TunerTools/TTuaefi/gerber/alphax_4ch.csv

Comment | Designator | Footprint | LCSC Part #
10n | C1 | hellen-one-common:C0603 | C57112
100n | C2 | hellen-one-common:C0603 | C14663
10n | C3 | hellen-one-common:C0603 | C57112
1n | C4 | hellen-one-common:C0603 | C1588
100n | C5 | hellen-one-common:C0603 | C14663
100n | C6 | hellen-one-common:C0603 | C14663
22u | C7 | hellen-one-common:C0603 | C59461
1n 250V | C8 | hellen-one-common:C0603 | C277510
1n 250V | C9 | hellen-one-common:C0603 | C277510
1n 250V | C17 | hellen-one-common:C0603 | C277510
100n | C18 | hellen-one-common:C0603 | C14663
100n | C19 | hellen-one-common:C0603 | C14663
1n 250V | C20 | hellen-one-common:C0603 | C277510
1n 250V | C21 | hellen-one-common:C0603 | C277510
470uF | C22 | Capacitor_SMD:CP_Elec_10x10.5
10u | C45 | hellen-one-common:C0805 | C15850
10u | C46 | hellen-one-common:C0805 | C15850
10u | C47 | hellen-one-common:C0805 | C15850
10u | C48 | hellen-one-common:C0805 | C15850
10u | C49 | hellen-one-common:C0805 | C15850
10u | C50 | hellen-one-common:C0805 | C15850
10u | C51 | hellen-one-common:C0805 | C15850
10u | C52 | hellen-one-common:C0805 | C15850
10u | C53 | hellen-one-common:C0805 | C15850
10u | C54 | hellen-one-common:C0805 | C15850
100n | C55 | hellen-one-common:C0603 | C14663
1N4148WS | D1 | hellen-one-common:SOD-323 | C2128
1N4148WS | D2 | hellen-one-common:SOD-323 | C2128
1N4148WS | D3 | hellen-one-common:SOD-323 | C2128
LED-WHITE-0603 | D4 | hellen-one-common:LED-0603 | C2290
1N4148WS | D5 | hellen-one-common:SOD-323 | C2128
1N4148WS | D6 | hellen-one-common:SOD-323 | C2128
1N4148WS | D7 | hellen-one-common:SOD-323 | C2128
1N4148WS | D8 | hellen-one-common:SOD-323 | C2128
LED-RED-0603 | D9 | hellen-one-common:LED-0603 | C2286
LED-WHITE-0603 | D10 | hellen-one-common:LED-0603 | C2290
LED-RED-0603 | D13 | hellen-one-common:LED-0603 | C2286
LED-RED-0603 | D14 | hellen-one-common:LED-0603 | C2286
LED-RED-0603 | D15 | hellen-one-common:LED-0603 | C2286
LED-RED-0603 | D16 | hellen-one-common:LED-0603 | C2286
LED-RED-0603 | D17 | hellen-one-common:LED-0603 | C2286
BAT54S | D18 | Package_TO_SOT_SMD:SOT-23 | C47546
BAT54S | D19 | Package_TO_SOT_SMD:SOT-23 | C47546
LED-GREEN-0603 | D20 | hellen-one-common:LED-0603 | C72043
1N4148WS | D21 | hellen-one-common:SOD-323 | C2128
1N4148WS | D22 | hellen-one-common:SOD-323 | C2128
BAT54S | D23 | Package_TO_SOT_SMD:SOT-23 | C47546
1N4148WS | D24 | hellen-one-common:SOD-323 | C2128
PSM712-LF | D25 | hellen-one-common:SOT-23 | C32677
B5819W | D26 | hellen-one-common:SOD-123 | C8598
B5819W | D27 | hellen-one-common:SOD-123 | C8598
PSM712-LF | D28 | hellen-one-common:SOT-23 | C32677
PSM712-LF | D29 | hellen-one-common:SOT-23 | C32677
LED-RED-0603 | D31 | hellen-one-common:LED-0603 | C2286
LED-RED-0603 | D32 | hellen-one-common:LED-0603 | C2286
LED-WHITE-0603 | D33 | hellen-one-common:LED-0603 | C2290
LED-WHITE-0603 | D34 | hellen-one-common:LED-0603 | C2290
LED-WHITE-0603 | D35 | hellen-one-common:LED-0603 | C2290
LED-WHITE-0603 | D36 | hellen-one-common:LED-0603 | C2290
1N4148WS | D37 | hellen-one-common:SOD-323 | C2128
1N4148WS | D38 | hellen-one-common:SOD-323 | C2128
LED-RED-0603 | D39 | hellen-one-common:LED-0603 | C2286
LED-RED-0603 | D40 | hellen-one-common:LED-0603 | C2286
1N4148WS | D41 | hellen-one-common:SOD-323 | C2128
1N4148WS | D42 | hellen-one-common:SOD-323 | C2128
LED-RED-0603 | D43 | hellen-one-common:LED-0603 | C2286
LED-RED-0603 | D44 | hellen-one-common:LED-0603 | C2286
1N4148WS | D45 | hellen-one-common:SOD-323 | C2128
1N4148WS | D46 | hellen-one-common:SOD-323 | C2128
LED-RED-0603 | D47 | hellen-one-common:LED-0603 | C2286
LED-RED-0603 | D48 | hellen-one-common:LED-0603 | C2286
B5819W | D49 | hellen-one-common:SOD-123 | C8598
B5819W | D50 | hellen-one-common:SOD-123 | C8598
B5819W | D51 | hellen-one-common:SOD-123 | C8598
B5819W | D52 | hellen-one-common:SOD-123 | C8598
1N4148WS | D53 | hellen-one-common:SOD-323 | C2128
BAT54S | D55 | Package_TO_SOT_SMD:SOT-23 | C47546
LED-RED-0603 | D56 | hellen-one-common:LED-0603 | C2286
LED-RED-0603 | D57 | hellen-one-common:LED-0603 | C2286
BAT54S | D58 | Package_TO_SOT_SMD:SOT-23 | C47546
B5819W | D64 | hellen-one-common:SOD-123 | C8598
B5819W | D65 | hellen-one-common:SOD-123 | C8598
B5819W | D66 | hellen-one-common:SOD-123 | C8598
B5819W | D67 | hellen-one-common:SOD-123 | C8598
B5819W | D68 | hellen-one-common:SOD-123 | C8598
B5819W | D69 | hellen-one-common:SOD-123 | C8598
B5819W | D70 | hellen-one-common:SOD-123 | C8598
B5819W | D71 | hellen-one-common:SOD-123 | C8598
B5819W | D72 | hellen-one-common:SOD-123 | C8598
nSMD005 | F1 | hellen-one-common:PAD-1206-PAD | C369153
nSMD005 | F2 | hellen-one-common:PAD-1206-PAD | C369153
nSMD050 | F3 | hellen-one-common:PAD-1206-PAD | C720075
nSMD050 | F4 | hellen-one-common:PAD-1206-PAD | C720075
12H1500D | F5 | hellen-one-common:PAD-1206-PAD | C182446
12H1500D | F6 | hellen-one-common:PAD-1206-PAD | C182446
nSMD050 | F7 | hellen-one-common:PAD-1206-PAD | C720075
nSMD005 | F8 | hellen-one-common:PAD-1206-PAD | C369153
nSMD005 | F9 | hellen-one-common:PAD-1206-PAD | C369153
nSMD005 | F10 | hellen-one-common:PAD-1206-PAD | C369153
nSMD005 | F11 | hellen-one-common:PAD-1206-PAD | C369153
RUSEFI_LOGO | G1 | kicad6-libraries:rusefi_logo
LOGO | G3 | hellen-one-common:LOGO
LOGO_AlphaECU | G4 | kicad6-libraries:alphax_logo_AlphaECU
LOGO_AlphaX | G5 | kicad6-libraries:alphax_logo_AlphaX
ALPHAX_QR_CODE | G6 | kicad6-libraries:alphax_qr_code
Disclaimer | G7 | kicad6-libraries:Off_Road_Disclaimer
USB_C_Receptacle_USB2.0 | J1 | Connector_USB:USB_C_Receptacle_XKB_U262-16XN-4BVC11 | C2927038
Cortex_Debug | J2 | hellen-one-common:PinHeader_2x05_P1.27mm_Vertical_SMD | C448647
Conn_01x01 | J3 | TestPoint:TestPoint_Pad_D2.0mm
Conn_01x01 | J4 | TestPoint:TestPoint_Pad_D2.0mm
Conn_01x05_Male | J5 | Connector_Molex:Molex_SPOX_5267-05A_1x05_P2.50mm_Vertical
430451012 | J6 | Connector_Molex:Molex_Micro-Fit_3.0_43045-1012_2x05_P3.00mm_Vertical | C239457
Conn_01x01 | J7 | MountingHole:MountingHole_4.5mm_Pad
Conn_01x01 | J8 | MountingHole:MountingHole_4.5mm_Pad
Module-power_12and5V-0.2 | M1 | hellen-one-power_12and5V-0.2:power_12and5V
Module-ign8-0.2 | M2 | hellen-one-ign8-0.2:ign8
Module-vr-discrete-0.4 | M3 | hellen-one-vr-discrete-0.4:vr-discrete
Module-mega-mcu144-0.5 | M4 | hellen-one-mega-mcu144-0.5:mega-mcu144
Module-ign8-0.2 | M6 | hellen-one-ign8-0.2:ign8
Module-vr-discrete-0.4 | M8 | hellen-one-vr-discrete-0.4:vr-discrete
Module-knock-0.2 | M9 | hellen-one-knock-0.2:knock
HCCPHPE24BKA90F | P1 | kicad6-libraries:33311-24AW-2
HCCPHPE24BGYB90F | P2 | kicad6-libraries:33311-24AW-2
Pad | P4 | hellen-one-common:PAD-TH
Pad | P16 | hellen-one-common:PAD-TH
Pad | P17 | hellen-one-common:PAD-TH
Pad | P18 | hellen-one-common:PAD-TH
Pad | P19 | hellen-one-common:PAD-TH
Pad | P21 | hellen-one-common:PAD-TH
Pad | P22 | hellen-one-common:PAD-TH
Pad | P23 | hellen-one-common:PAD-TH
Pad | P24 | hellen-one-common:PAD-TH
Pad | P25 | hellen-one-common:PAD-TH
Pad | P26 | hellen-one-common:PAD-TH
Pad | P27 | hellen-one-common:PAD-TH
Pad | P28 | hellen-one-common:PAD-TH
AO3400A | Q1 | hellen-one-common:SOT-23 | C20917
PJM2319PSA | Q2 | Package_TO_SOT_SMD:SOT-23 | C411720
AO3400A | Q3 | hellen-one-common:SOT-23 | C20917
AO3400A | Q4 | hellen-one-common:SOT-23 | C20917
VND14NV04-E | Q6 | hellen-one-common:DPAK | C155647
VND14NV04-E | Q7 | hellen-one-common:DPAK | C155647
AO3400A | Q8 | hellen-one-common:SOT-23 | C20917
AO3400A | Q9 | hellen-one-common:SOT-23 | C20917
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
2k | R1141 | Resistor_SMD:R_1206_3216Metric | C17944
MAX9924UAUB+ | U1 | Package_SO:MSOP-10_3x3mm_P0.5mm | C143633
MPXH6400A | U3 | hellen-one-common:MPXH6400A-SSOP8 | C511770
JDY-33 | U4 | kicad6-libraries:JDY-33
TLE9201SG | U7 | Package_SO:Infineon_PG-DSO-12-11 | C112633
