TunerTools/TTuaefi/bom_pullups_alphax_4ch-g.csv

#CRANK 680k UP
R220 | 680k | R0402 | C163456
R226
#CAM EXT
R220
R224
#VSS EXT
R219
R223
#TPS 680k DOWN
R204
R208 | 680k | R0402 | C163456
#TPS2 EXT
R202
R206
#PPS 680k DOWN
R203
R207 | 680k | R0402 | C163456
#PPS2 EXT
R201
R205
#IAT EXT
R213
R217
#AT1 4.7k UP
R212 | 4.7k | R0402 | C25900
R216
#CLT EXT
R211
R215
#AT2 4.7k UP
R210 | 4.7k | R0402 | C25900
R214
#O2S 680k DOWN
R238
R242 | 680k | R0402 | C163456
#O2S2 680k DOWN
R239
R243 | 680k | R0402 | C163456
#RES1 680k UP
R237 | 680k | R0402 | C163456
R241
C216 | 10n | C0603 | C15195
#RES2 EXT
R240
R244
C219
#RES3 EXT
R231
R235
C215
#MAP1 10k DOWN
R228
R232 | 10k | R0402 | C11616
#MAP2 10k DOWN
R229
R233 | 10k | R0402 | C11616
#MAP3 10k DOWN
R230
R234 | 10k | R0402 | C11616
#AUX1 680k DOWN
R246
R250 | 680k | R0402 | C163456
#AUX2 680k DOWN
R247
R251 | 680k | R0402 | C163456
#AUX3 EXT
R248
R252
#AUX4 EXT
R249
R253
C228
#SENS1 EXT
R259
R263
#SENS2 EXT
R260
R264
#SENS3 EXT
R261
R265
#SENS4 EXT
R262
R266
#KNOCK 680k DOWN
R221
R225 | 680k | R0402 | C163456
#D1-D4 0 series
R140 | 0 | R0603x4 | C1952
#D1 EXT
R124
R136
#D2 EXT
R126
R137
#D3 EXT
R132
R138
#D4 EXT
R135
R139
