TunerTools/TTuaefi/bom_pullups_alphax_4ch-h.csv

#CRANK CRANK VR: UP 680k 1n
R222,"680k","R0402","C163456"
R226,
C211,"1n","C0402","C1523"
#CAM CAM HALL: DOWN DNP 1n
R220,
R224,
C209,"1n","C0402","C1523"
#VSS 2STEP: DOWN DNP 1n
R219,
R223,
C208,"1n","C0402","C1523"
#TPS TPS1: DOWN 680k 100n
R204,
R208,"680k","R0402","C163456"
C203,"100n","C0402","C307331"
#TPS2 AIN1: DOWN DNP 1n
R202,
R206,
C201,"1n","C0402","C1523"
#PPS PPS1: DOWN 680k 100n
R203,
R207,"680k","R0402","C163456"
C202,"100n","C0402","C307331"
#PPS2 AIN2: DOWN DNP 1n
R201,
R205,
C200,"1n","C0402","C1523"
#IAT IAT: UP DNP 100n
R213,
R217,
C207,"100n","C0402","C307331"
#AT1 PAD: UP 4.7k 100n
R212,"4.7k","R0402","C25900"
R216,
C206,"100n","C0402","C307331"
#CLT CLT: UP DNP 100n
R211,
R215,
C205,"100n","C0402","C307331"
#AT2 PAD: UP 4.7k 100n
R210,"4.7k","R0402","C25900"
R214,
C204,"100n","C0402","C307331"
#O2S WakeUP: DOWN 680k 100n
R238,
R242,"680k","R0402","C163456"
C217,"100n","C0402","C307331"
#O2S2 AFR: DOWN 680k 100n
R239,
R243,"680k","R0402","C163456"
C218,"100n","C0402","C307331"
#RES1 CAM VR: UP 680k 1n
R237,"680k","R0402","C163456"
R241,
C216,"1n","C0402","C1523"
#RES2 CAM VR ANALOG: UP DNP 1n
R240,
R244,
C219,"1n","C0402","C1523"
#RES3 CRANK VR ANALOG: UP DNP 1n
R231,
R235,
C215,"1n","C0402","C1523"
#MAP1 AIN3: DOWN DNP 1n
R228,
R232,
C212,"1n","C0402","C1523"
#MAP2 MAP: DOWN 10k 10n
R229,
R233,"10k","R0402","C25744"
C213,"10n","C0402","C15195"
#MAP3 MAP2: DOWN 10k 10n
R230,
R234,"10k","R0402","C25744"
C214,"10n","C0402","C15195"
#AUX1 TPS2: DOWN 680k 100n
R246,
R250,"680k","R0402","C163456"
C225,"100n","C0402","C307331"
#AUX2 PPS2: DOWN 680k 100n
R247,
R251,"680k","R0402","C163456"
C226,"100n","C0402","C307331"
#AUX3 AIN4: DOWN DNP 1n
R248,
R252,
C227,"1n","C0402","C1523"
#AUX4 FLEX: UP DNP DNP
R249,
R253,
C228,
#SENS1 D2: UP DNP 1n
R259,
R263,
C230,"1n","C0402","C1523"
#SENS2 D3: UP DNP 1n
R260,
R264,
C231,"1n","C0402","C1523"
#SENS3 D4: UP DNP 1n
R261,
R265,
C232,"1n","C0402","C1523"
#SENS4 D5: UP DNP 1n
R262,
R266,
C233,"1n","C0402","C1523"
#KNOCK KNOCK: DOWN 680k 1n
R221,
R225,"680k","R0402","C163456"
C210,"1n","C0402","C1523"
#D1 HALL1: UP DNP 1n
R124,
R136,
C143,"1n","C0402","C1523"
#D2 TLS115_PG: UP DNP 1n
R126,
R137,
C144,"1n","C0402","C1523"
#D3 HALL2: UP DNP 1n
R132,
R138,
C145,"1n","C0402","C1523"
#D4 HALL3: UP DNP 1n
R135,
R139,
C146,"1n","C0402","C1523"
