TunerTools/TTuaefi/gerber/alphax_4ch.pdf

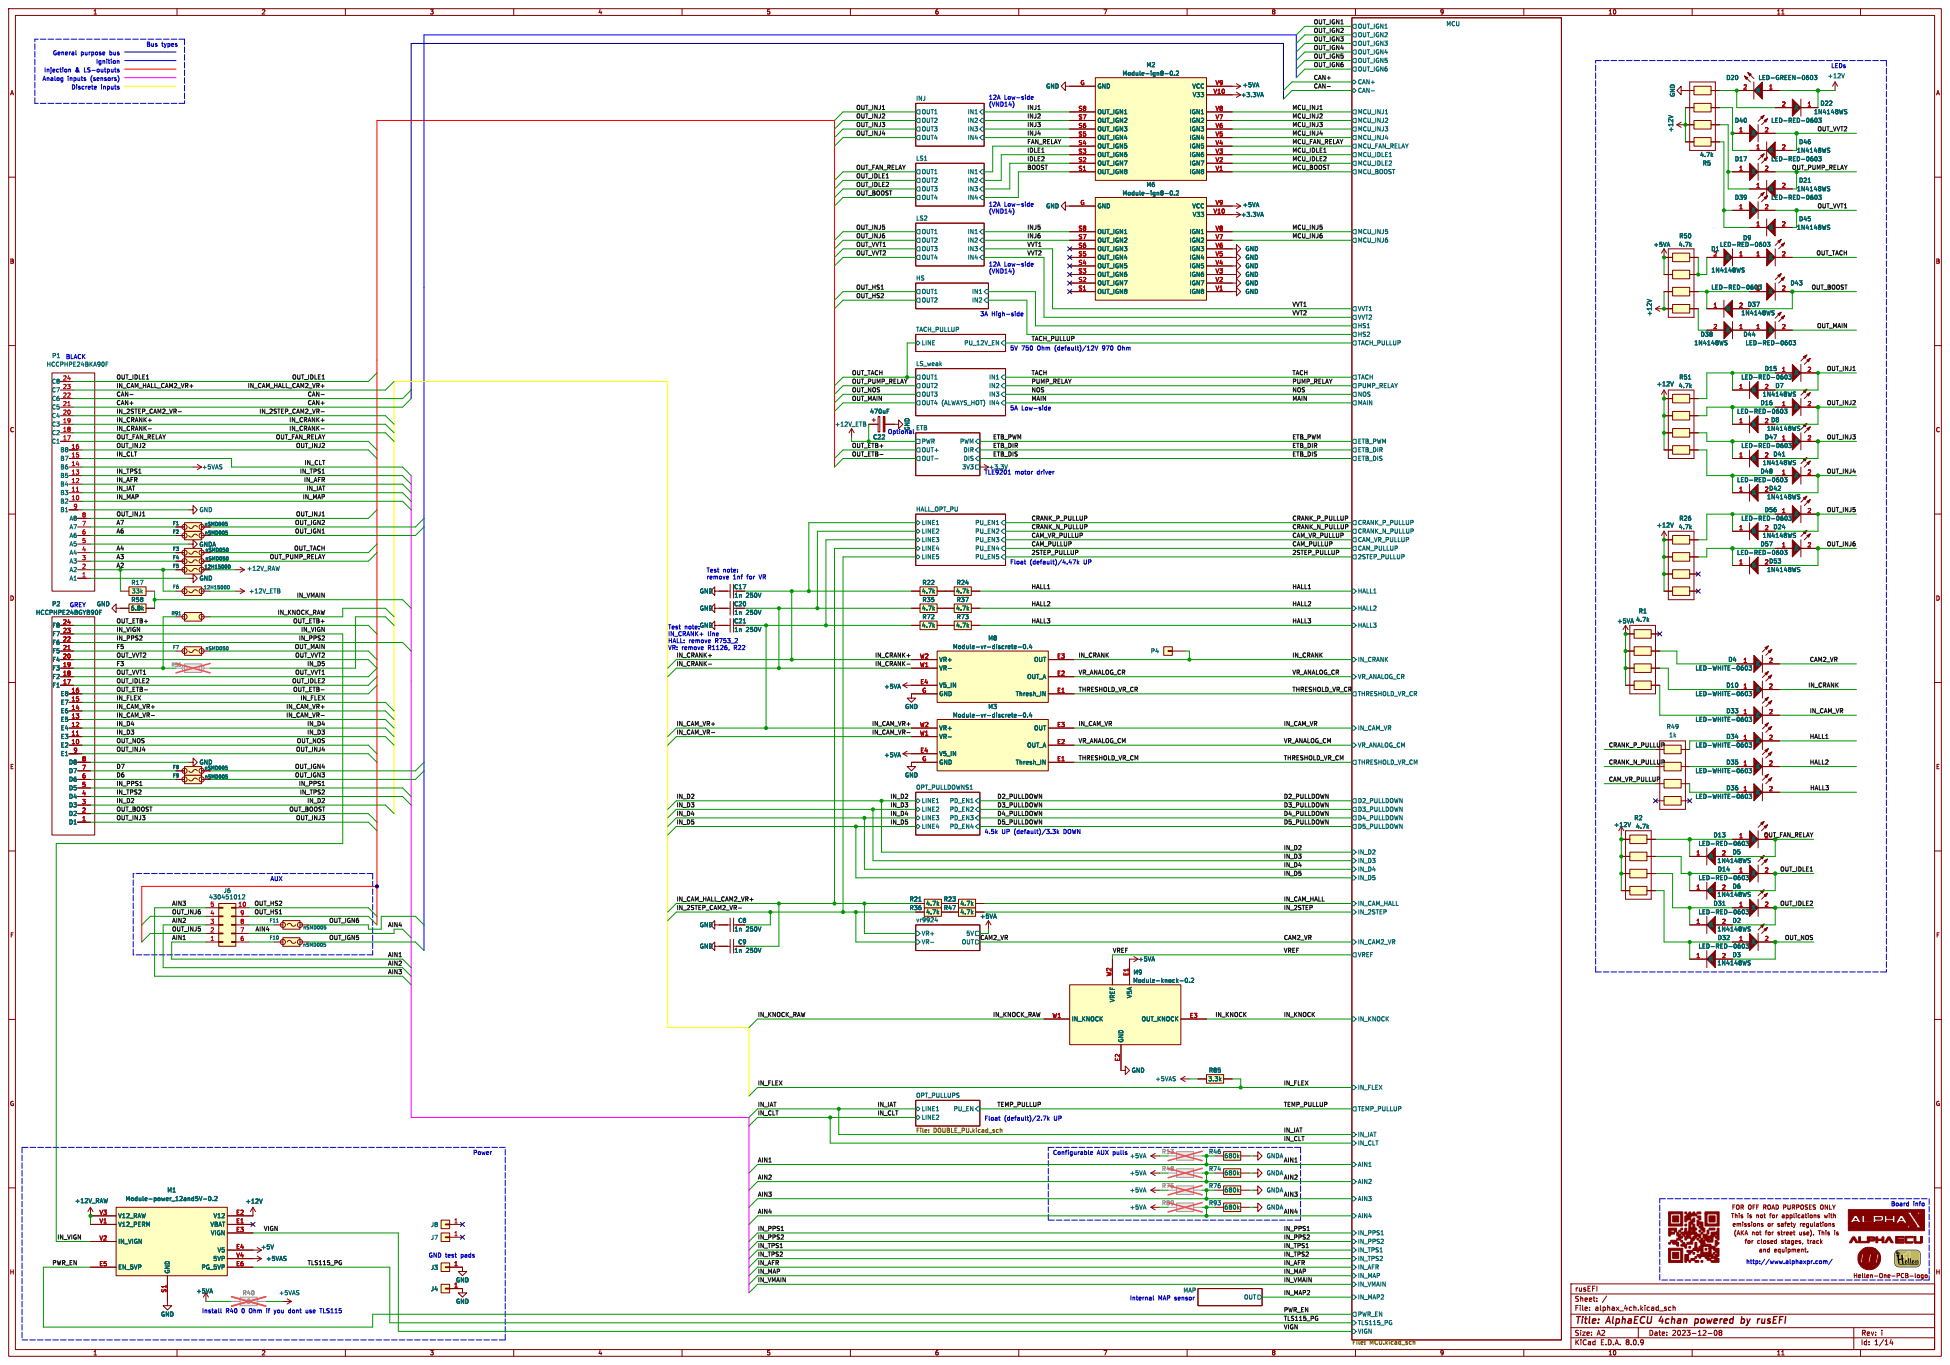
[picture p1: page 1]

+5VA GND GND GND GND GND GND

TLE9201 motor driver 5A Low-side

Test note: remove 1nf for VR

Test note:
IN_CRANK+ line HALL: remove R753_2 VR: remove R1126, R22

for closed stages, track FOR OFF ROAD PURPOSES ONLY

http://www.alphaxpr.com/

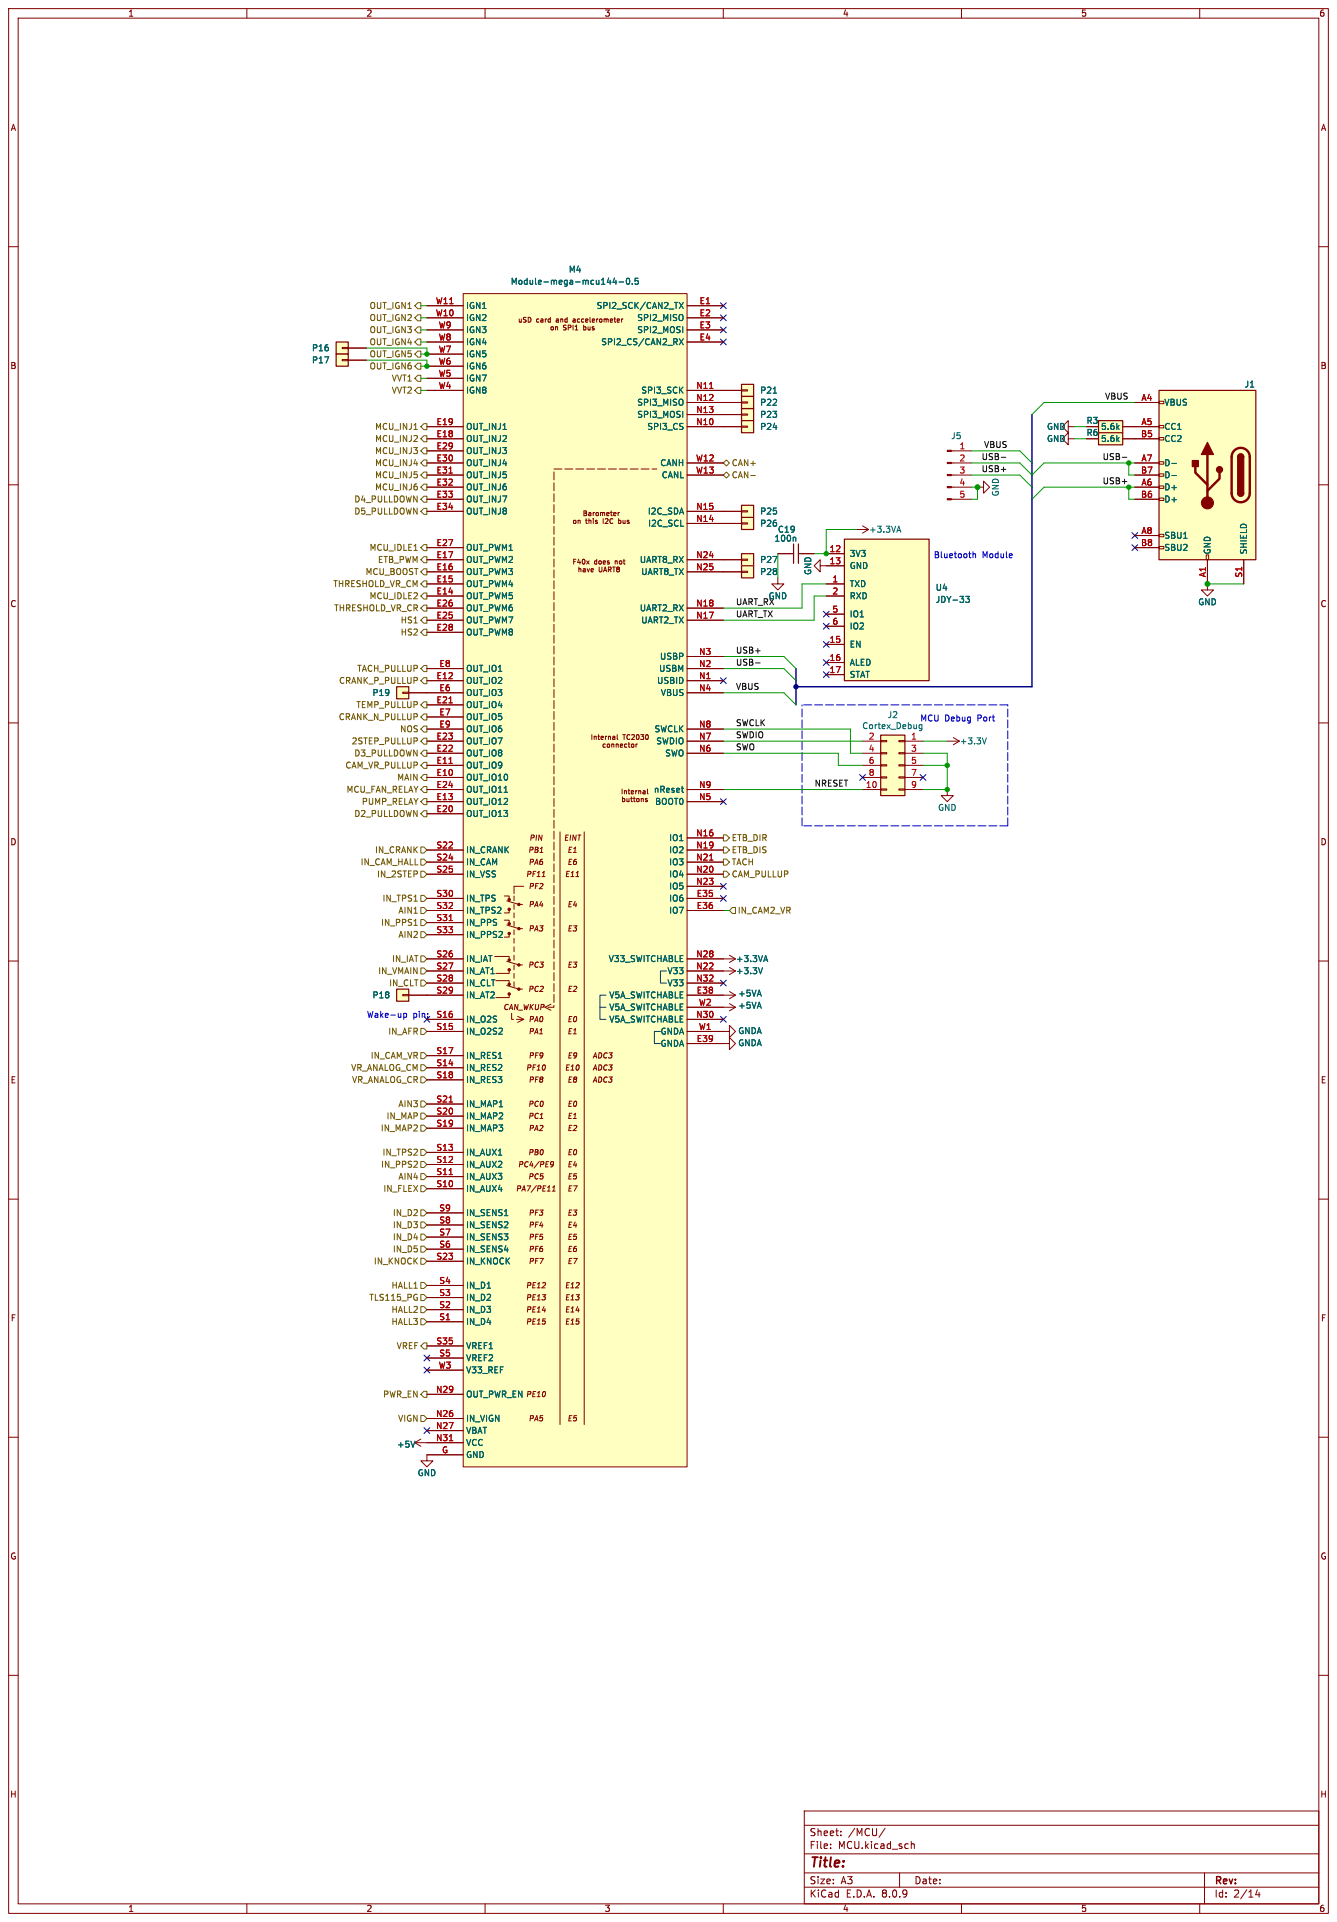
[picture p2: page 2]

100n P28GND
3V3 12 GND 13 EN 15 ALED 16 STAT 17 RXD 2
IO2 6 GND
JDY-33 TXD 1

Id: 2/14 Title: File: MCU.kicad_sch Sheet: /MCU/

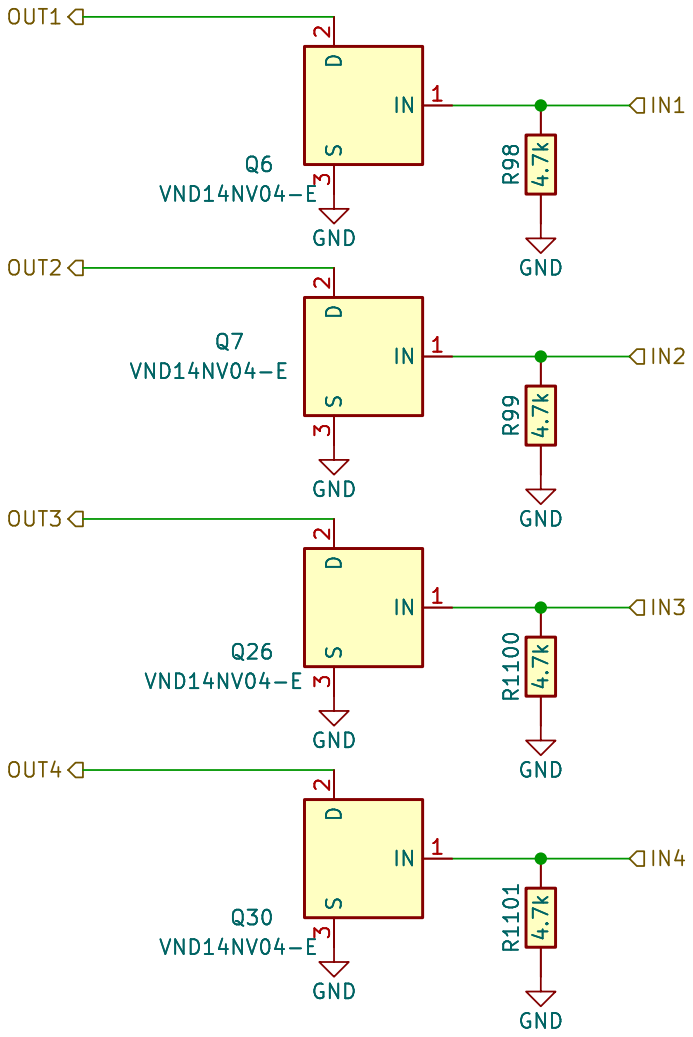
[picture p3: page 3]

Id: 3/14 Title: File: INJ4.kicad_sch Sheet: /INJ/

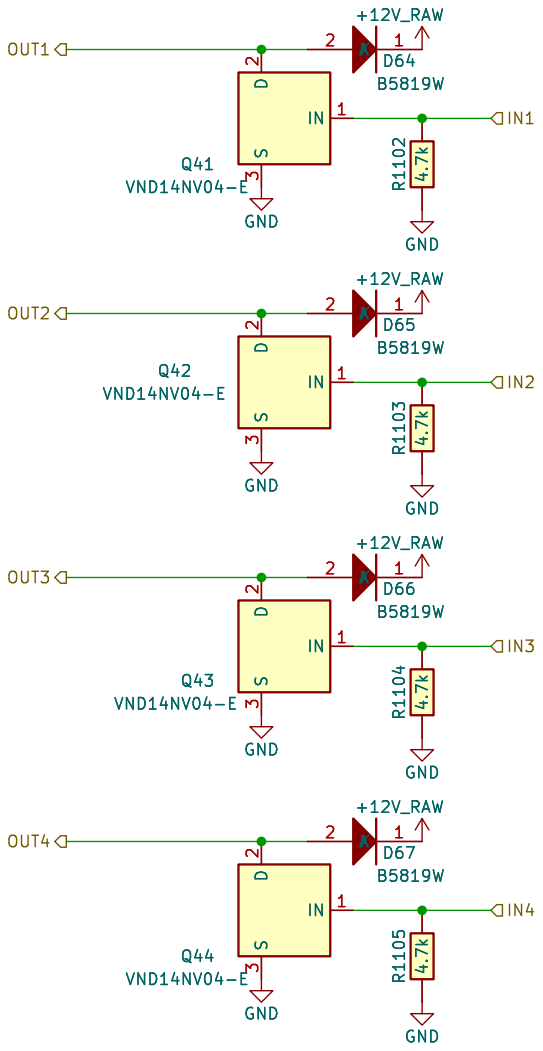
[picture p4: page 4]

Id: 4/14 Title: File: LS4.kicad_sch Sheet: /LS1/ GND

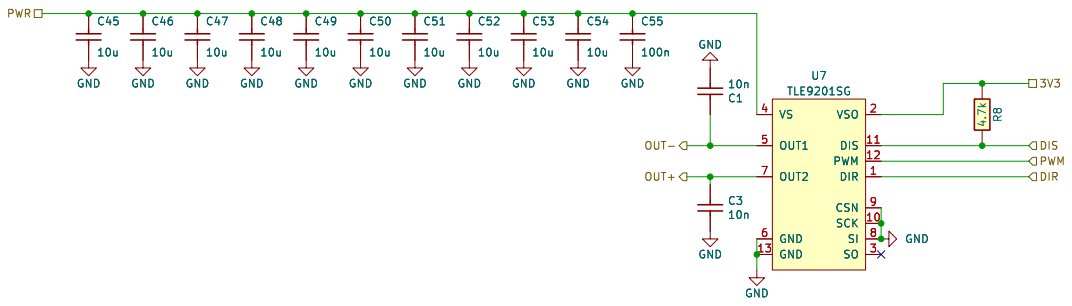
[picture p5: page 5]

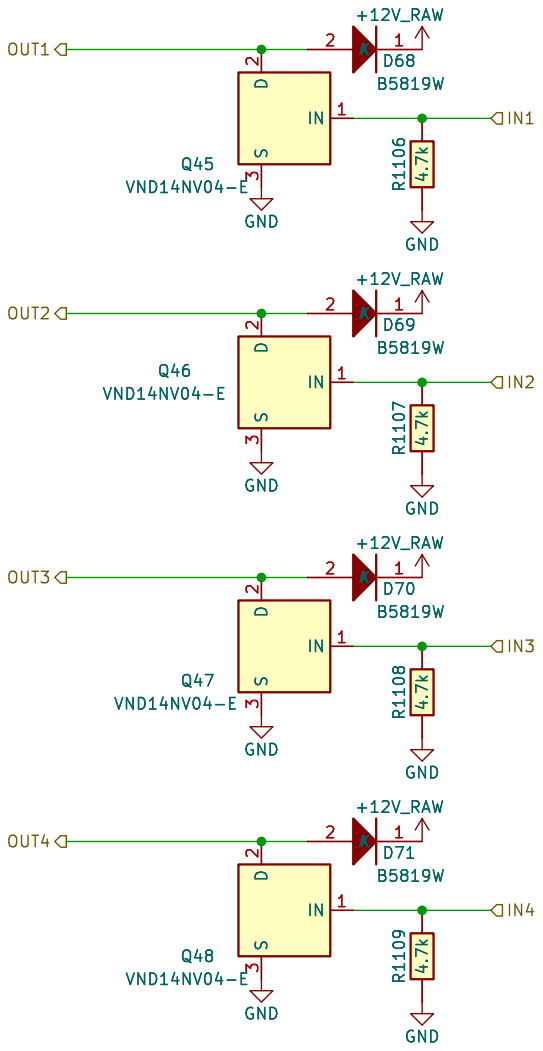
[picture p6: page 6]

Id: 6/14 Title: File: LS4.kicad_sch Sheet: /LS2/

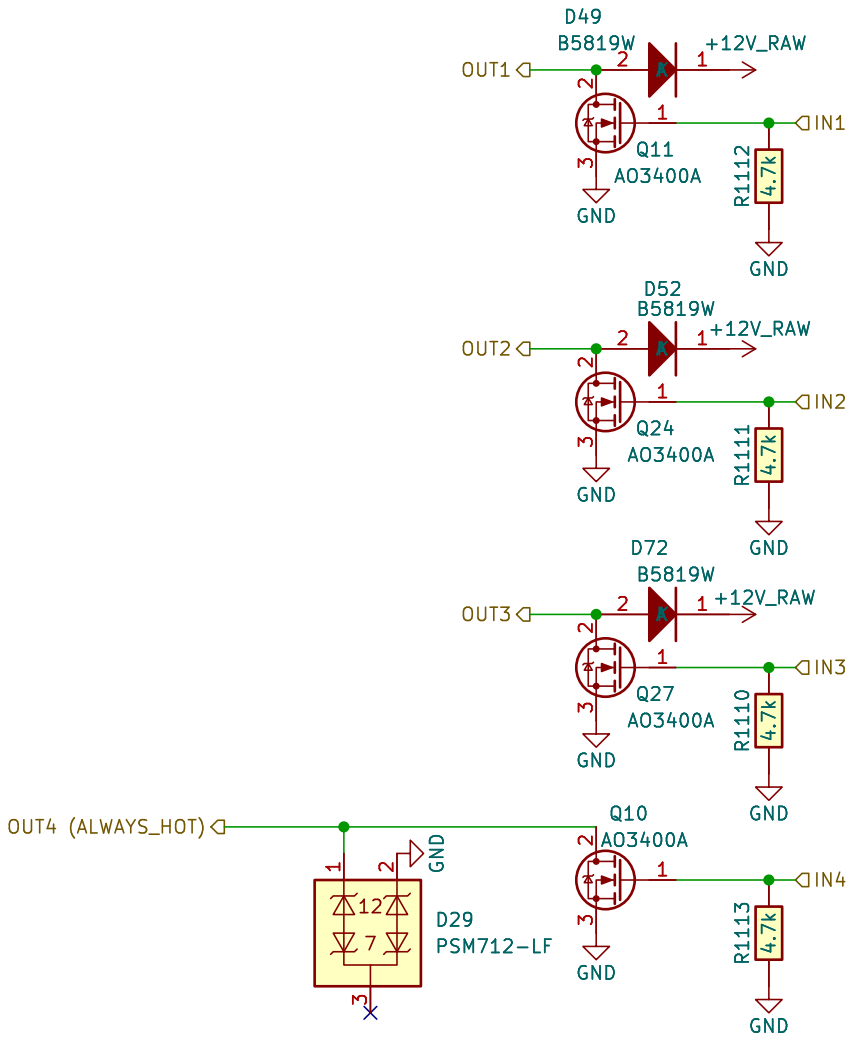
[picture p7: page 7]

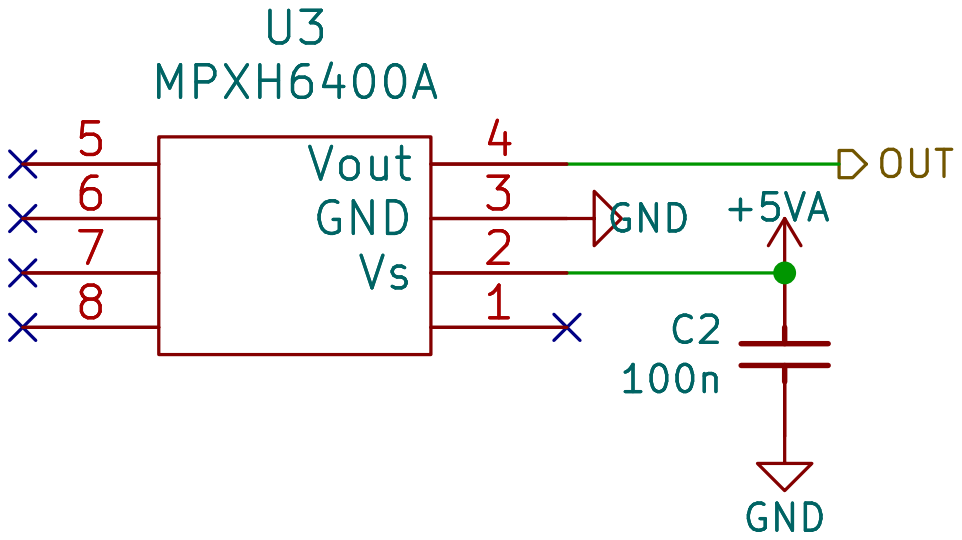
[picture p8: page 8]

Id: 8/14 Title: File: MAP.kicad_sch Sheet: /MAP/

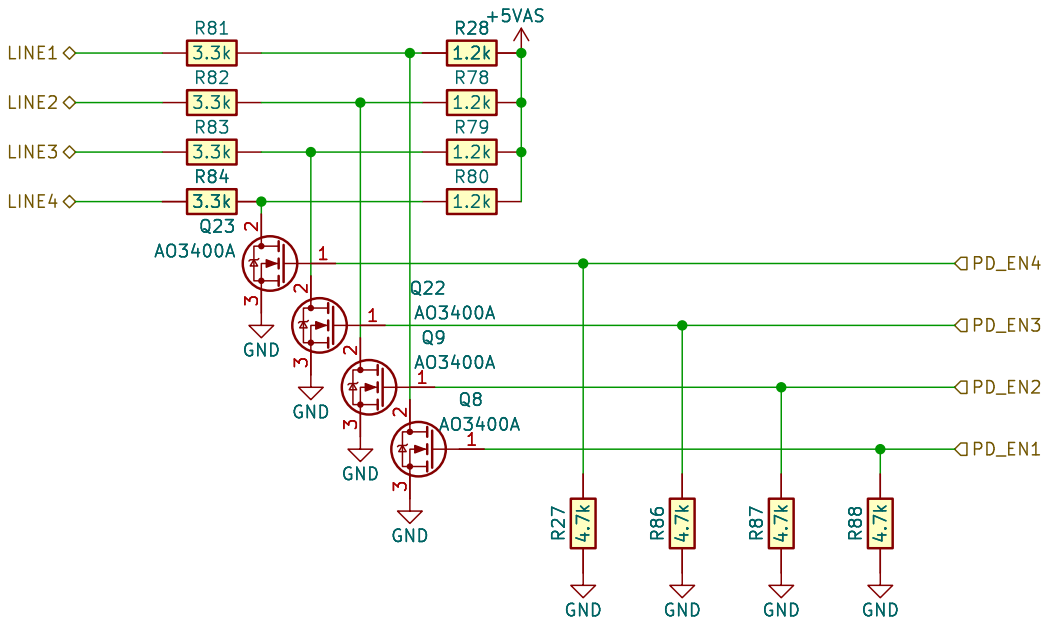
[picture p9: page 9]

2 3 GND GND R27 4.7k R86 4.7k GND GND GND R87 4.7k R88 4.7k R28

1.2k GND

Id: 9/14 Title: File: PD4.kicad_sch Sheet: /OPT_PULLDOWNS1/ GND

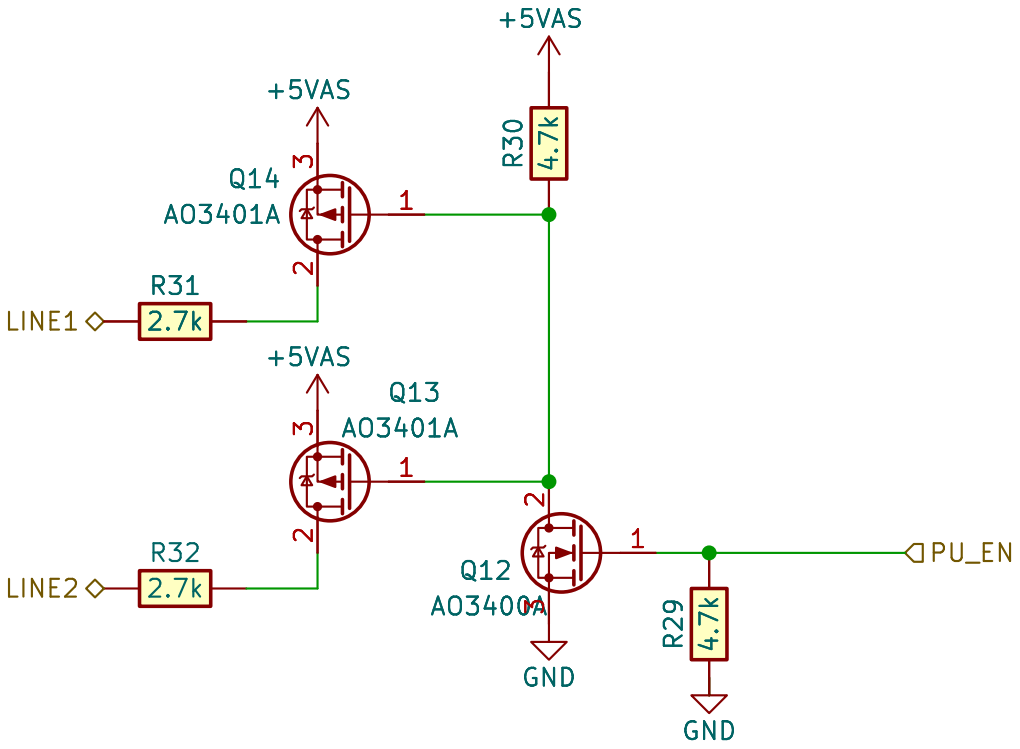
[picture p10: page 10]

Id: 11/14 Title: File: DOUBLE_PU.kicad_sch Sheet: /OPT_PULLUPS/

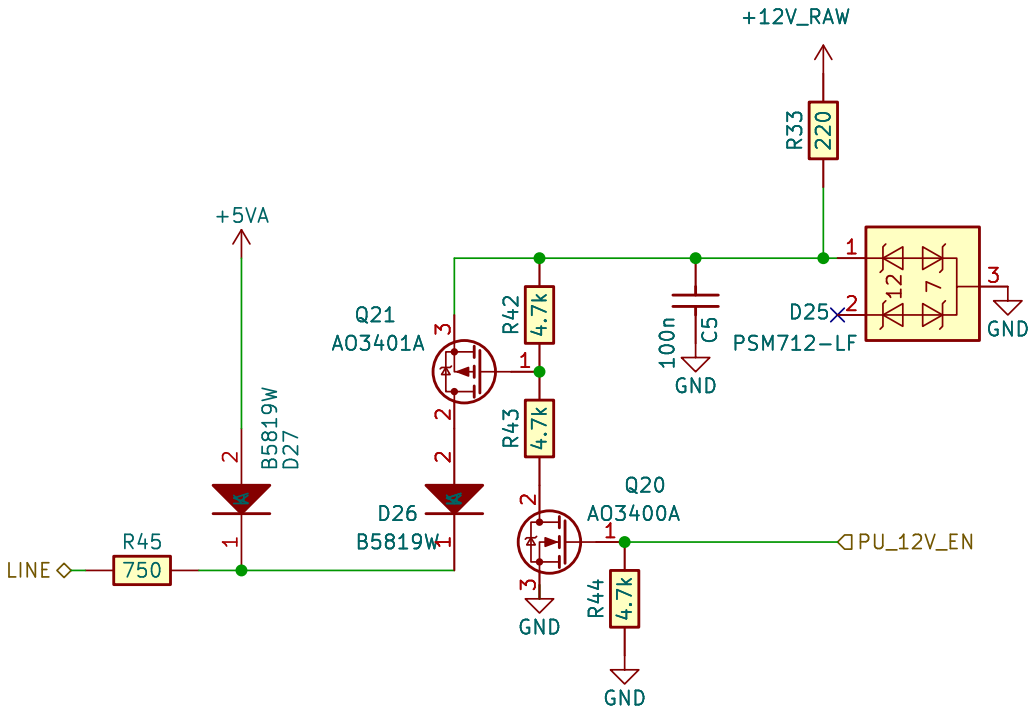
[picture p11: page 11]

Id: 12/14 Title: File: TACH_PU.kicad_sch Sheet: /TACH_PULLUP/

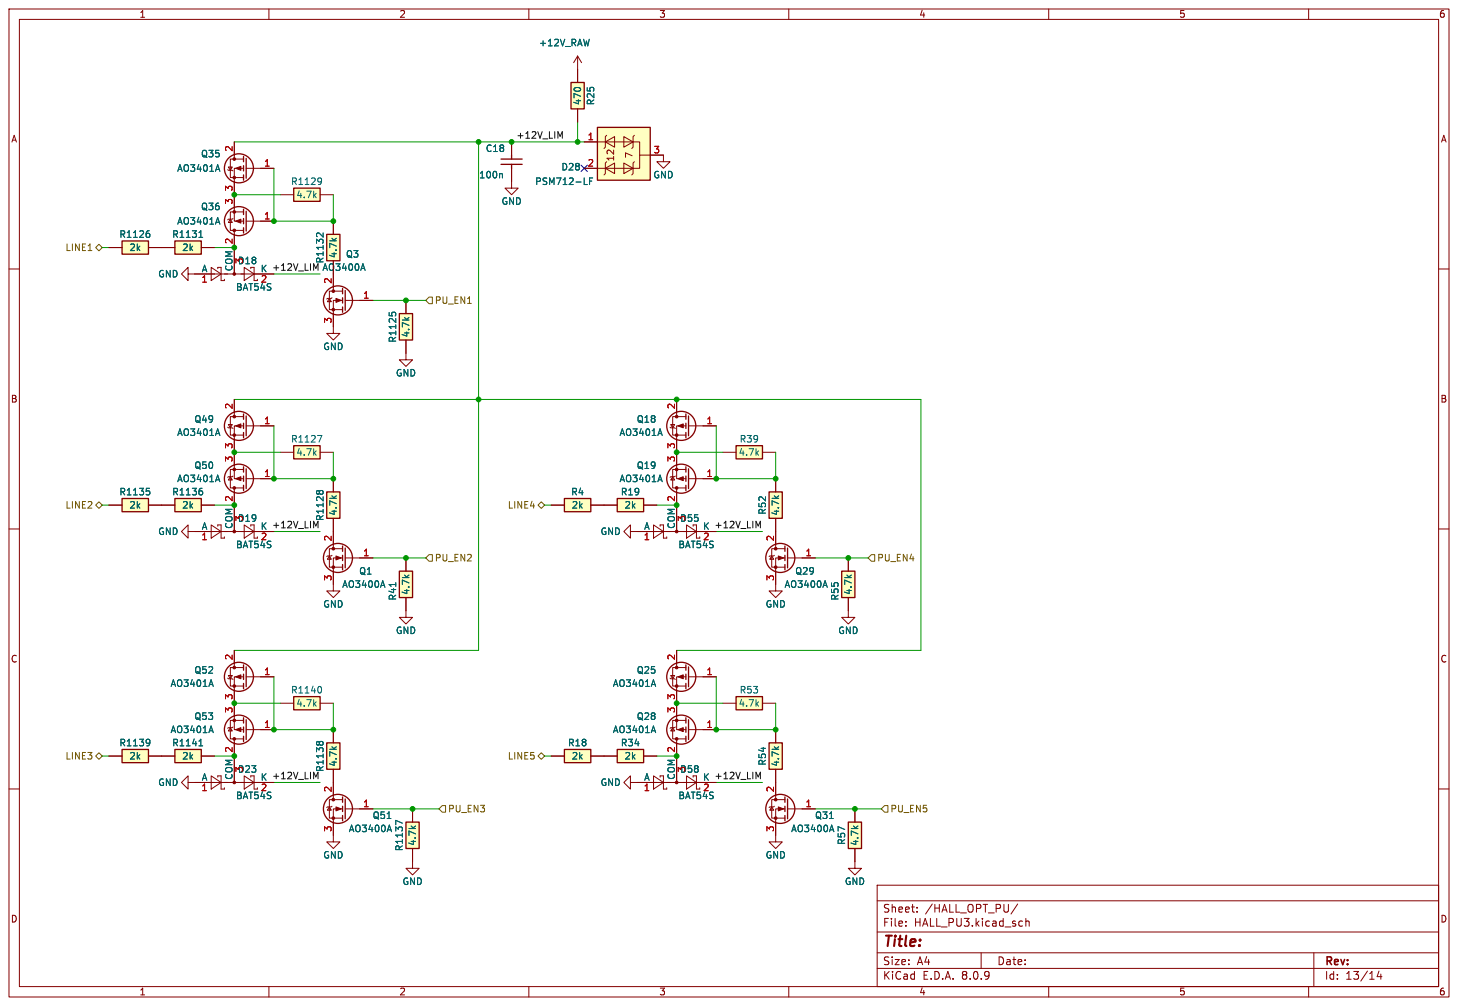
[picture p12: page 12]

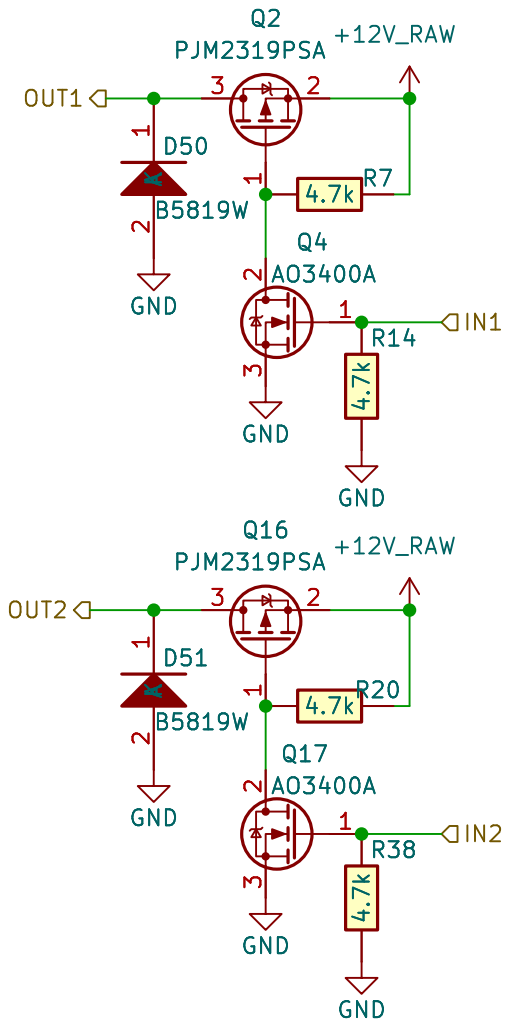
[picture p13: page 13]

Id: 14/14 Title: File: HS2.kicad_sch Sheet: /HS/

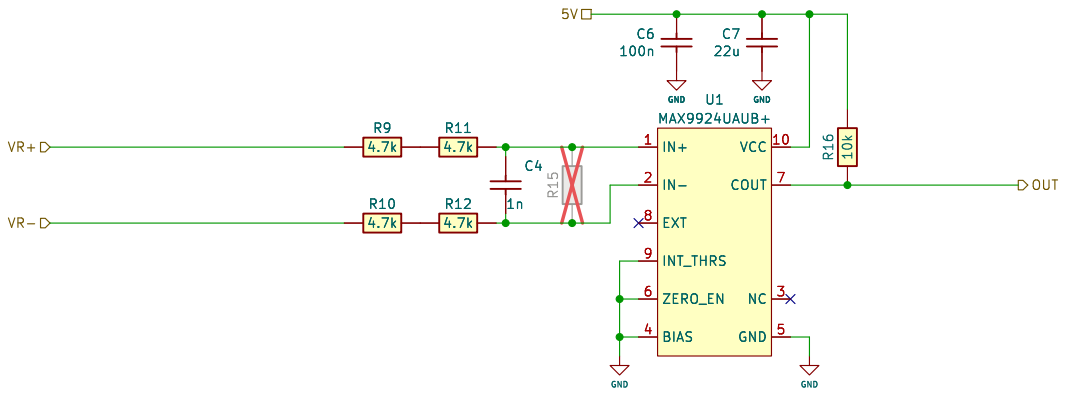
[picture p14: page 14]

Id: 15/14 Title: File: vr9924.kicad_sch Sheet: /vr9924/
