TunerTools/TTuaefi/alphax_4ch.kicad_pcb

## KiCad design alphax_4ch.kicad_pcb (2025-11-16)

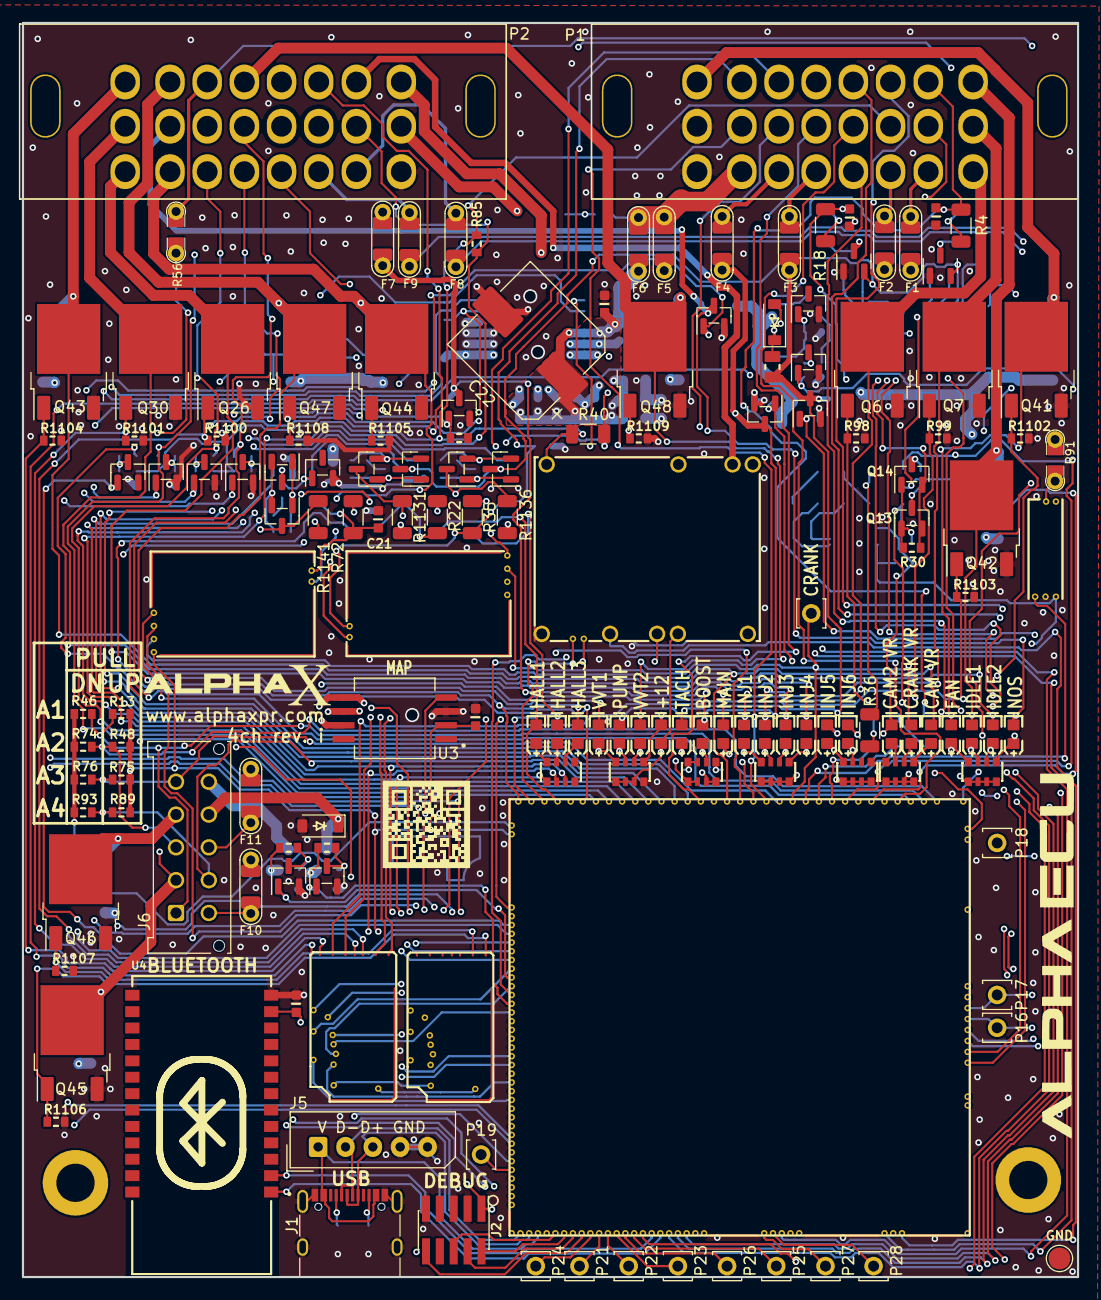
[picture p15: board alphax_4ch.kicad_pcb from above]

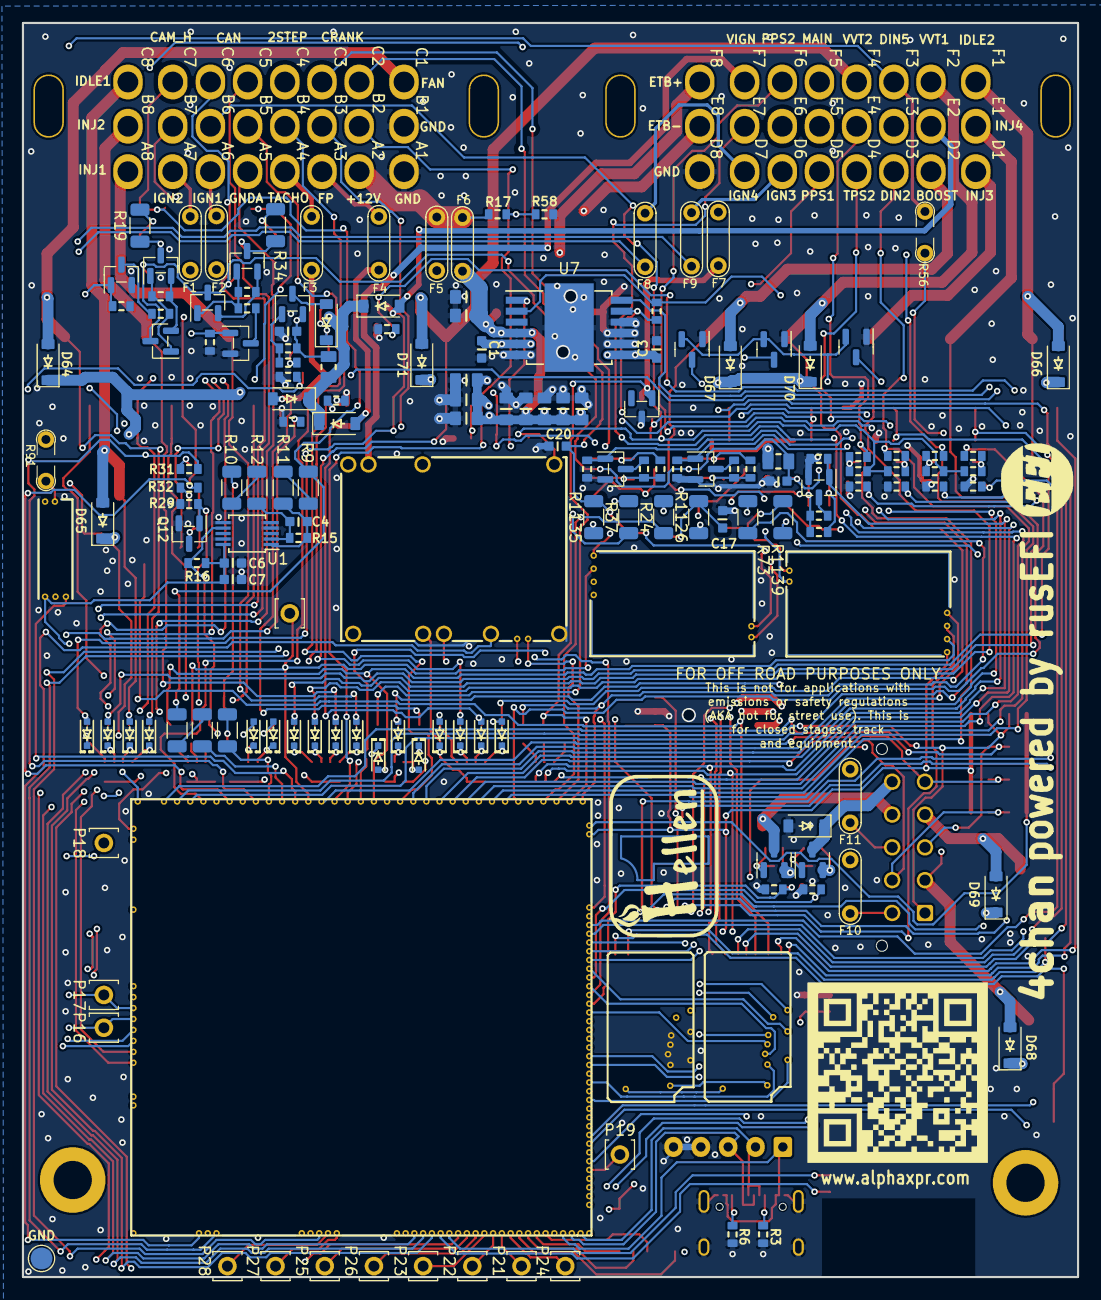
[picture p16: board alphax_4ch.kicad_pcb from below]

Board: 4 copper layers, 96.5 x 114.7 mm, 291 parts (134 on the bottom side), 230 nets.

Parts:
C1, C3: 10n; C0603
C2, C5, C6, C18, C19, C55: 100n; C0603
C4: 1n; C0603
C7: 22u; C0603
C8, C9, C17, C20, C21: 1n 250V; C0603
C22: 470uF; CP_Elec_10x10.5
C45, C46, C47, C48, C49, C50, C51, C52, C53, C54: 10u; C0805
D1, D2, D3, D5, D6, D7, D8, D21, D22, D24, D37, D38, D41, D42, D45, D46, D53: 1N4148WS; SOD-323
D4, D10, D33, D34, D35, D36: LED-WHITE-0603; LED-0603
D9, D13, D14, D15, D16, D17, D31, D32, D39, D40, D43, D44, D47, D48, D56, D57: LED-RED-0603; LED-0603
D18, D19, D23, D55, D58: BAT54S; SOT-23
D20: LED-GREEN-0603; LED-0603
D25, D28, D29: PSM712-LF; SOT-23
D26, D27, D49, D50, D51, D52, D64, D65, D66, D67, D68, D69, D70, D71, D72: B5819W; SOD-123
F1, F2, F8, F9, F10, F11: nSMD005; PAD-1206-PAD
F3, F4, F7: nSMD050; PAD-1206-PAD
F5, F6: 12H1500D; PAD-1206-PAD
G1: RUSEFI_LOGO; rusefi_logo
G3: LOGO
G4: LOGO_AlphaECU; alphax_logo_AlphaECU
G5: LOGO_AlphaX; alphax_logo_AlphaX
G6: ALPHAX_QR_CODE; alphax_qr_code
G7: Disclaimer; Off_Road_Disclaimer
J1: USB_C_Receptacle_USB2.0; USB_C_Receptacle_XKB_U262-16XN-4BVC11
J2: Cortex_Debug; PinHeader_2x05_P1.27mm_Vertical_SMD
J3, J4: Conn_01x01; TestPoint_Pad_D2.0mm
J5: Conn_01x05_Male; Molex_SPOX_5267-05A_1x05_P2.50mm_Vertical
J6: 430451012; Molex_Micro-Fit_3.0_43045-1012_2x05_P3.00mm_Vertical
J7, J8: Conn_01x01; MountingHole_4.5mm_Pad
M1: Module-power_12and5V-0.2; power_12and5V
M2, M6: Module-ign8-0.2; ign8
M3, M8: Module-vr-discrete-0.4; vr-discrete
M4: Module-mega-mcu144-0.5; mega-mcu144
M9: Module-knock-0.2; knock
P1: HCCPHPE24BKA90F; 33311-24AW-2
P2: HCCPHPE24BGYB90F; 33311-24AW-2
P4, P16, P17, P18, P19, P21, P22, P23, P24, P25, P26, P27, P28: Pad; PAD-TH
Q1, Q3, Q4, Q8, Q9, Q10, Q11, Q12, Q17, Q20, Q22, Q23, Q24, Q27, Q29, Q31, Q51: AO3400A; SOT-23
Q2, Q16: PJM2319PSA; SOT-23
Q6, Q7, Q26, Q30, Q41, Q42, Q43, Q44, Q45, Q46, Q47, Q48: VND14NV04-E; DPAK
Q13, Q14, Q18, Q19, Q21, Q25, Q28, Q35, Q36, Q49, Q50, Q52, Q53: AO3401A; SOT-23
R1, R2, R5, R26, R50, R51: 4.7k; R0603-4
R3, R6: 5.6k; R0603
R4, R18, R19, R34, R1126, R1131, R1135, R1136, R1139, R1141: 2k; R_1206_3216Metric
R7, R8, R14, R20, R27, R29, R30, R38, R39, R41, R42, R43, R44, R52, R53, R54, R55, R57, R86, R87, R88, R98, R99, R1100, R1101, R1102, R1103, R1104, R1105, R1106, R1107, R1108, R1109, R1110, R1111, R1112, R1113, R1125, R1127, R1128, R1129, R1132, R1137, R1138, R1140: 4.7k; R0603
R9, R10, R11, R12, R21, R22, R23, R24, R35, R36, R37, R47, R72, R73: 4.7k; R_1206_3216Metric
R13, R15, R48, R75, R89: R0603
R16: 10k; R0603
R17: 33k; R0603
R25: 470; R0805
R28, R78, R79, R80: 1.2k; R0603
R31, R32: 2.7k; R0603
R33: 220; R0805
R40: SMD1206B035TF/16; R_1206_3216Metric
R45: 750; R0805
R46, R74, R76, R93: 680k; R0603
R49: 1k; R0603-4
R56, R91: Jumper-Pad-Pad; PAD-0805-PAD
R58: 6.8k; R0603
R81, R82, R83, R84, R85: 3.3k; R0603
U1: MAX9924UAUB+; MSOP-10_3x3mm_P0.5mm
U3: MPXH6400A; MPXH6400A-SSOP8
U4: JDY-33
U7: TLE9201SG; Infineon_PG-DSO-12-11

Connections:
+3.3V: J2.1, M4.N22 (V33), R8.2, U7.2 (VSO)
+3.3VA: C19.2, M2.V10 (V33), M4.N28 (V33_SWITCHABLE), M6.V10 (V33), U4.12 (3V3)
+5V: M1.E4 (V5), M4.N31 (VCC)
+5VA: C2.2, C6.2, C7.2, D27.2 (A), M2.V9 (VCC), M3.E4 (V5_IN), M4.E38 (V5A_SWITCHABLE), M4.W2 (V5A_SWITCHABLE), M6.V9 (VCC), M8.E4 (V5_IN), M9.E1 (V5A), R1.1, R1.2, R1.3, R1.4, R13.2, R16.2, R40.1, R48.2, R50.1, R50.2, R75.2, R89.2, U1.10 (VCC), U3.2 (Vs)
+5VAS: M1.V4 (5VP), P1.14 (B6), Q13.3 (S), Q14.3 (S), R28.2, R30.2, R40.2, R78.2, R79.2, R80.2, R85.2
+12V: D20.1 (A), D22.1 (K), M1.E2 (V12), R2.1, R2.2, R2.3, R2.4, R5.1, R5.2, R5.3, R26.1, R26.2, R26.3, R26.4, R50.3, R50.4, R51.1, R51.2, R51.3, R51.4
+12V_ETB: C22.1, C45.2, C46.2, C47.2, C48.2, C49.2, C50.2, C51.2, C52.2, C53.2, C54.2, C55.2, F6.2, U7.4 (VS)
+12V_RAW: D49.1 (K), D52.1 (K), D64.1 (K), D65.1 (K), D66.1 (K), D67.1 (K), D68.1 (K), D69.1 (K), D70.1 (K), D71.1 (K), D72.1 (K), F5.2, M1.V1 (V12_PERM), M1.V3 (V12_RAW), Q2.2 (S), Q16.2 (S), R7.2, R20.2, R25.2, R33.2
/2STEP_PULLUP: M4.E23 (OUT_IO7), Q31.1 (G), R57.1
/A2: F5.1, F6.1, P1.2 (A2), R17.1
/A3: F4.1, P1.3 (A3)
/A4: F3.1, P1.4 (A4)
/A6: F2.1, P1.6 (A6)
/A7: F1.1, P1.7 (A7)
/AIN1: J6.1, M4.S32 (IN_TPS2), R13.1, R46.2
/AIN2: J6.3, M4.S33 (IN_PPS2), R48.1, R74.2
/AIN3: J6.5, M4.S21 (IN_MAP1), R75.1, R76.2
/AIN4: J6.7, M4.S11 (IN_AUX3), R89.1, R93.2
/BOOST: M2.S1 (OUT_IGN8), Q44.1 (IN), R1105.1
/CAM2_VR: D4.2 (K), M4.E36 (IO7), R16.1, U1.7 (COUT)
/CAM_PULLUP: M4.N20 (IO4), Q29.1 (G), R55.2
/CAM_VR_PULLUP: M4.E11 (OUT_IO9), Q51.1 (G), R49.3, R1137.1
/CAN+: M4.W12 (CANH), P1.21 (C5)
/CAN-: M4.W13 (CANL), P1.22 (C6)
/CRANK_N_PULLUP: M4.E7 (OUT_IO5), Q1.1 (G), R41.2, R49.2
/CRANK_P_PULLUP: M4.E12 (OUT_IO2), Q3.1 (G), R49.1, R1125.2
/D2_PULLDOWN: M4.E20 (OUT_IO13), Q8.1 (G), R88.1
/D3_PULLDOWN: M4.E22 (OUT_IO8), Q9.1 (G), R87.1
/D4_PULLDOWN: M4.E33 (OUT_INJ7), Q22.1 (G), R86.1
/D5_PULLDOWN: M4.E34 (OUT_INJ8), Q23.1 (G), R27.1
/D6: F9.1, P2.6 (D6)
/D7: F8.1, P2.7 (D7)
/ETB_DIR: M4.N16 (IO1), U7.1 (DIR)
/ETB_DIS: M4.N19 (IO2), R8.1, U7.11 (DIS)
/ETB_PWM: M4.E17 (OUT_PWM2), U7.12 (PWM)
/F3: P2.19 (F3), R56.2, R91.2
/F5: F7.1, P2.21 (F5)
/FAN_RELAY: M2.S4 (OUT_IGN5), Q41.1 (IN), R1102.1
/HALL1: D34.2 (K), M4.S4 (IN_D1), R24.1
/HALL2: D35.2 (K), M4.S2 (IN_D3), R37.1
/HALL3: D36.2 (K), M4.S1 (IN_D4), R73.1
/HALL_OPT_PU/+12V_LIM: C18.2, D18.2 (K), D19.2 (K), D23.2 (K), D28.1, D55.2 (K), D58.2 (K), Q18.2 (D), Q25.2 (D), Q35.2 (D), Q49.2 (D), Q52.2 (D), R25.1
/HS/IN1: M4.E25 (OUT_PWM7), Q4.1 (G), R14.1
/HS/IN2: M4.E28 (OUT_PWM8), Q17.1 (G), R38.1
/IDLE1: M2.S3 (OUT_IGN6), Q42.1 (IN), R1103.1
/IDLE2: M2.S2 (OUT_IGN7), Q43.1 (IN), R1104.1
/INJ1: M2.S8 (OUT_IGN1), Q6.1 (IN), R98.1
/INJ2: M2.S7 (OUT_IGN2), Q7.1 (IN), R99.1
/INJ3: M2.S6 (OUT_IGN3), Q26.1 (IN), R1100.1
/INJ4: M2.S5 (OUT_IGN4), Q30.1 (IN), R1101.1
/INJ5: M6.S8 (OUT_IGN1), Q45.1 (IN), R1106.1
/INJ6: M6.S7 (OUT_IGN2), Q46.1 (IN), R1107.1
/IN_2STEP: M4.S25 (IN_VSS), R47.1
/IN_2STEP_CAM2_VR-: C8.2, P1.20 (C4), R10.2, R18.2, R36.2
/IN_AFR: M4.S15 (IN_O2S2), P1.12 (B4)
/IN_CAM_HALL: M4.S24 (IN_CAM), R23.1
/IN_CAM_HALL_CAM2_VR+: C9.2, P1.23 (C7), R4.2, R9.2, R21.2
/IN_CAM_VR: D33.2 (K), M3.E3 (OUT), M4.S17 (IN_RES1)
/IN_CAM_VR+: C21.2, M3.W2 (VR+), P2.14 (E6), R72.2, R1139.2
/IN_CAM_VR-: M3.W1 (VR-), P2.13 (E5)
/IN_CLT: M4.S28 (IN_CLT), P1.15 (B7), R32.2
/IN_CRANK: D10.2 (K), M4.S22 (IN_CRANK), M8.E3 (OUT), P4.1
/IN_CRANK+: C17.2, M8.W2 (VR+), P1.19 (C3), R22.2, R1126.2
/IN_CRANK-: C20.2, M8.W1 (VR-), P1.18 (C2), R35.2, R1135.2
/IN_D2: M4.S9 (IN_SENS1), P2.3 (D3), R81.1
/IN_D3: M4.S8 (IN_SENS2), P2.11 (E3), R82.1
/IN_D4: M4.S7 (IN_SENS3), P2.12 (E4), R83.1
/IN_D5: M4.S6 (IN_SENS4), R56.1, R84.1
/IN_FLEX: M4.S10 (IN_AUX4), P2.15 (E7), R85.1
/IN_IAT: M4.S26 (IN_IAT), P1.11 (B3), R31.2
/IN_KNOCK: M4.S23 (IN_KNOCK), M9.E3 (OUT_KNOCK)
/IN_KNOCK_RAW: M9.W1 (IN_KNOCK), R91.1
/IN_MAP: M4.S20 (IN_MAP2), P1.10 (B2)
/IN_MAP2: M4.S19 (IN_MAP3), U3.4 (Vout)
/IN_PPS1: M4.S31 (IN_PPS), P2.5 (D5)
/IN_PPS2: M4.S12 (IN_AUX2), P2.22 (F6)
/IN_TPS1: M4.S30 (IN_TPS), P1.13 (B5)
/IN_TPS2: M4.S13 (IN_AUX1), P2.4 (D4)
/IN_VIGN: M1.V2 (IN_VIGN), P2.23 (F7)
/IN_VMAIN: M4.S27 (IN_AT1), R17.2, R58.2
/MAIN: M4.E10 (OUT_IO10), Q10.1 (G), R1113.1
/MCU/NRESET: J2.10, M4.N9 (nReset)
/MCU/SWCLK: J2.4, M4.N8 (SWCLK)
/MCU/SWDIO: J2.2, M4.N7 (SWDIO)
/MCU/SWO: J2.6, M4.N6 (SWO)
/MCU/UART_RX: M4.N18 (UART2_RX), U4.1 (TXD)
/MCU/UART_TX: M4.N17 (UART2_TX), U4.2 (RXD)
/MCU/USB+: J1.A6 (D+), J1.B6 (D+), J5.3, M4.N3 (USBP)
/MCU/USB-: J1.A7 (D-), J1.B7 (D-), J5.2, M4.N2 (USBM)
/MCU/VBUS: J1.A4 (VBUS), J1.A9 (VBUS), J1.B4 (VBUS), J1.B9 (VBUS), J5.1, M4.N4 (VBUS)
/MCU_BOOST: M2.V1 (IGN8), M4.E16 (OUT_PWM3)
/MCU_FAN_RELAY: M2.V4 (IGN5), M4.E24 (OUT_IO11)
/MCU_IDLE1: M2.V3 (IGN6), M4.E27 (OUT_PWM1)
/MCU_IDLE2: M2.V2 (IGN7), M4.E14 (OUT_PWM5)
/MCU_INJ1: M2.V8 (IGN1), M4.E19 (OUT_INJ1)
/MCU_INJ2: M2.V7 (IGN2), M4.E18 (OUT_INJ2)
/MCU_INJ3: M2.V6 (IGN3), M4.E29 (OUT_INJ3)
/MCU_INJ4: M2.V5 (IGN4), M4.E30 (OUT_INJ4)
/MCU_INJ5: M4.E31 (OUT_INJ5), M6.V8 (IGN1)
/MCU_INJ6: M4.E32 (OUT_INJ6), M6.V7 (IGN2)
/NOS: M4.E9 (OUT_IO6), Q27.1 (G), R1110.1
/OUT_BOOST: D37.2 (A), D43.2 (K), D67.2 (A), P2.2 (D2), Q44.2 (D)
/OUT_ETB+: C3.2, P2.24 (F8), U7.7 (OUT2)
/OUT_ETB-: C1.2, P2.16 (E8), U7.5 (OUT1)
/OUT_FAN_RELAY: D5.2 (A), D13.2 (K), D64.2 (A), P1.17 (C1), Q41.2 (D)
/OUT_HS1: D50.1 (K), J6.9, Q2.3 (D)
/OUT_HS2: D51.1 (K), J6.10, Q16.3 (D)
/OUT_IDLE1: D6.2 (A), D14.2 (K), D65.2 (A), P1.24 (C8), Q42.2 (D)
/OUT_IDLE2: D2.2 (A), D31.2 (K), D66.2 (A), P2.17 (F1), Q43.2 (D)
/OUT_IGN1: F2.2, M4.W11 (IGN1)
/OUT_IGN2: F1.2, M4.W10 (IGN2)
/OUT_IGN3: F9.2, M4.W9 (IGN3)
/OUT_IGN4: F8.2, M4.W8 (IGN4)
/OUT_IGN5: F10.2, M4.W7 (IGN5), P16.1
/OUT_IGN6: F11.2, M4.W6 (IGN6), P17.1
/OUT_INJ1: D7.2 (A), D15.2 (K), P1.8 (A8), Q6.2 (D)
/OUT_INJ2: D8.2 (A), D16.2 (K), P1.16 (B8), Q7.2 (D)
/OUT_INJ3: D41.2 (A), D47.2 (K), P2.1 (D1), Q26.2 (D)
/OUT_INJ4: D42.2 (A), D48.2 (K), P2.9 (E1), Q30.2 (D)
/OUT_INJ5: D24.2 (A), D56.2 (K), D68.2 (A), J6.2, Q45.2 (D)
/OUT_INJ6: D53.2 (A), D57.2 (K), D69.2 (A), J6.4, Q46.2 (D)
/OUT_MAIN: D29.1, D44.2 (K), F7.2, Q10.2 (D)
/OUT_NOS: D3.2 (A), D32.2 (K), D72.2 (A), P2.10 (E2), Q27.2 (D)
/OUT_PUMP_RELAY: D17.2 (K), D21.2 (A), D52.2 (A), F4.2, Q24.2 (D)
/OUT_TACH: D9.2 (K), D49.2 (A), F3.2, Q11.2 (D), R45.2
/OUT_VVT1: D39.2 (K), D45.2 (A), D70.2 (A), P2.18 (F2), Q47.2 (D)
/OUT_VVT2: D40.2 (K), D46.2 (A), D71.2 (A), P2.20 (F4), Q48.2 (D)
/PUMP_RELAY: M4.E13 (OUT_IO12), Q24.1 (G), R1111.1
/PWR_EN: M1.E5 (EN_5VP), M4.N29 (OUT_PWR_EN)
/TACH: M4.N21 (IO3), Q11.1 (G), R1112.1
/TACH_PULLUP: M4.E8 (OUT_IO1), Q20.1 (G), R44.2
/TEMP_PULLUP: M4.E21 (OUT_IO4), Q12.1 (G), R29.1
/THRESHOLD_VR_CM: M3.E1 (Thresh_IN), M4.E15 (OUT_PWM4)
/THRESHOLD_VR_CR: M4.E26 (OUT_PWM6), M8.E1 (Thresh_IN)
/TLS115_PG: M1.E6 (PG_5VP), M4.S3 (IN_D2)
/VIGN: M1.E3 (VIGN), M4.N26 (IN_VIGN)
/VREF: M4.S35 (VREF1), M9.W2 (VREF)
/VR_ANALOG_CM: M3.E2 (OUT_A), M4.S14 (IN_RES2)
/VR_ANALOG_CR: M4.S18 (IN_RES3), M8.E2 (OUT_A)
/VVT1: M4.W5 (IGN7), Q47.1 (IN), R1108.1
/VVT2: M4.W4 (IGN8), Q48.1 (IN), R1109.1
GND: C1.1, C2.1, C3.1, C5.1, C6.1, C7.1, C8.1, C9.1, C17.1, C18.1, C19.1, C20.1, C21.1, C22.2, C45.1, C46.1, C47.1, C48.1, C49.1, C50.1, C51.1, C52.1, C53.1, C54.1, C55.1, D18.1 (A), D19.1 (A), D23.1 (A), D25.3, D28.3, D29.2, D50.2 (A), D51.2 (A), D55.1 (A), D58.1 (A), J1.A1 (GND), J1.A12 (GND), J1.B1 (GND), J1.B12 (GND), J1.S1 (SHIELD), J2.3, J2.5, J2.9, J3.1, J4.1, J5.4, J5.5, M1.S1 (GND), M2.G (GND), M3.G (GND), M4.G (GND), M6.G (GND), M6.V1 (IGN8), M6.V2 (IGN7), M6.V3 (IGN6), M6.V4 (IGN5), M6.V5 (IGN4), M6.V6 (IGN3), M8.G (GND), M9.E2 (GND), P1.1 (A1), P1.9 (B1), P2.8 (D8), Q1.3 (S), Q3.3 (S), Q4.3 (S), Q6.3 (S), Q7.3 (S), Q8.3 (S), Q9.3 (S), Q10.3 (S), Q11.3 (S), Q12.3 (S), Q17.3 (S), Q20.3 (S), Q22.3 (S), Q23.3 (S), Q24.3 (S), Q26.3 (S), Q27.3 (S), Q29.3 (S), Q30.3 (S), Q31.3 (S), Q41.3 (S), Q42.3 (S), Q43.3 (S), Q44.3 (S), Q45.3 (S), Q46.3 (S), Q47.3 (S), Q48.3 (S), Q51.3 (S), R3.1, R5.4, R6.1, R14.2, R27.2, R29.2, R38.2, R41.1, R44.1, R55.1, R57.2, R58.1, R86.2, R87.2, R88.2, R98.2, R99.2, R1100.2, R1101.2, R1102.2, R1103.2, R1104.2, R1105.2, R1106.2, R1107.2, R1108.2, R1109.2, R1110.2, R1111.2, R1112.2, R1113.2, R1125.1, R1137.2, U1.4 (BIAS), U1.5 (GND), U1.6 (ZERO_EN), U1.9 (INT_THRS), U3.3 (GND), U4.13 (GND), U7.6 (GND), U7.8 (SI), U7.9 (CSN), U7.10 (SCK), U7.13 (GND)
GNDA: M4.E39 (GNDA), M4.W1 (GNDA), P1.5 (A5), R46.1, R74.1, R76.1, R93.1
unnamed: D1.2 (A), R50.7, R50.8
unnamed: D1.1 (K), D9.1 (A)
unnamed: D2.1 (K), D31.1 (A), R2.6
unnamed: D3.1 (K), D32.1 (A), R2.5
unnamed: D4.1 (A), R1.7
unnamed: D10.1 (A), R1.6
unnamed: D5.1 (K), D13.1 (A), R2.8
unnamed: D6.1 (K), D14.1 (A), R2.7
unnamed: D7.1 (K), D15.1 (A), R51.8
unnamed: D8.1 (K), D16.1 (A), R51.7
unnamed: D17.1 (A), D21.1 (K), R5.7
unnamed: D18.3 (COM), Q36.2 (D), R1131.1
unnamed: D19.3 (COM), Q50.2 (D), R1136.1
unnamed: D20.2 (K), D22.2 (A), R5.5
unnamed: D23.3 (COM), Q53.2 (D), R1141.1
unnamed: D24.1 (K), D56.1 (A), R26.8
unnamed: D26.2 (A), Q21.2 (D)
unnamed: D26.1 (K), D27.1 (K), R45.1
unnamed: D33.1 (A), R1.5
unnamed: D34.1 (A), R49.8
unnamed: D35.1 (A), R49.7
unnamed: D36.1 (A), R49.6
unnamed: D37.1 (K), D43.1 (A), R50.6
unnamed: D38.2 (A), R50.5
unnamed: D38.1 (K), D44.1 (A)
unnamed: D39.1 (A), D45.1 (K), R5.8
unnamed: D40.1 (A), D46.1 (K), R5.6
unnamed: D41.1 (K), D47.1 (A), R51.6
unnamed: D42.1 (K), D48.1 (A), R51.5
unnamed: D53.1 (K), D57.1 (A), R26.7
unnamed: D55.3 (COM), Q19.2 (D), R19.1
unnamed: D58.3 (COM), Q28.2 (D), R34.1
unnamed: J1.A5 (CC1), R3.2
unnamed: J1.B5 (CC2), R6.2
unnamed: F10.1, J6.6
unnamed: F11.1, J6.8
unnamed: M4.N14 (I2C_SCL), P26.1
unnamed: M4.N15 (I2C_SDA), P25.1
unnamed: M4.S29 (IN_AT2), P18.1
unnamed: M4.E6 (OUT_IO3), P19.1
unnamed: M4.N10 (SPI3_CS), P24.1
unnamed: M4.N12 (SPI3_MISO), P22.1
unnamed: M4.N13 (SPI3_MOSI), P23.1
unnamed: M4.N11 (SPI3_SCK), P21.1
unnamed: M4.N24 (UART8_RX), P27.1
unnamed: M4.N25 (UART8_TX), P28.1
unnamed: Q1.2 (D), R1128.1
unnamed: Q2.1 (G), Q4.2 (D), R7.1
unnamed: Q3.2 (D), R1132.1
unnamed: Q8.2 (D), R28.1, R81.2
unnamed: Q9.2 (D), R78.1, R82.2
unnamed: Q12.2 (D), Q13.1 (G), Q14.1 (G), R30.1
unnamed: Q13.2 (D), R32.1
unnamed: Q14.2 (D), R31.1
unnamed: Q16.1 (G), Q17.2 (D), R20.1
unnamed: Q18.1 (G), Q19.1 (G), R39.1, R52.2
unnamed: Q18.3 (S), Q19.3 (S), R39.2
unnamed: Q20.2 (D), R43.1
unnamed: Q21.1 (G), R42.1, R43.2
unnamed: C5.2, D25.1, Q21.3 (S), R33.1, R42.2
unnamed: Q22.2 (D), R79.1, R83.2
unnamed: Q23.2 (D), R80.1, R84.2
unnamed: Q25.1 (G), Q28.1 (G), R53.1, R54.2
unnamed: Q25.3 (S), Q28.3 (S), R53.2
unnamed: Q29.2 (D), R52.1
unnamed: Q31.2 (D), R54.1
unnamed: Q35.1 (G), Q36.1 (G), R1129.1, R1132.2
unnamed: Q35.3 (S), Q36.3 (S), R1129.2
unnamed: Q49.1 (G), Q50.1 (G), R1127.1, R1128.2
unnamed: Q49.3 (S), Q50.3 (S), R1127.2
unnamed: Q51.2 (D), R1138.1
unnamed: Q52.1 (G), Q53.1 (G), R1138.2, R1140.1
unnamed: Q52.3 (S), Q53.3 (S), R1140.2
unnamed: R10.1, R12.2
unnamed: R9.1, R11.2
unnamed: R18.1, R34.2
unnamed: R4.1, R19.2
unnamed: R21.1, R23.2
unnamed: R22.1, R24.2
unnamed: R35.1, R37.2
unnamed: R36.1, R47.2
unnamed: R72.1, R73.2
unnamed: R1126.1, R1131.2
unnamed: R1135.1, R1136.2
unnamed: R1139.1, R1141.2
unnamed: C4.2, R11.1, R15.2, U1.1 (IN+)
unnamed: C4.1, R12.1, R15.1, U1.2 (IN-)
