TunerTools/TTuaefi/(commit log)

2025-11-16 [skip actions] Auto-generated board v2.1
    [alphax_4ch-B_Cu.gbl, alphax_4ch-B_Mask.gbs, alphax_4ch-B_Paste.gbp, alphax_4ch-B_Silkscreen.gbo, alphax_4ch-Edge_Cuts.gm1, alphax_4ch-F_Cu.gtl, alphax_4ch-F_Mask.gts, alphax_4ch-F_Paste.gtp]
2025-11-20 GHA says update kicad6-libraries
